adaptivercsailing/adaptivercsailing/Update (As of 03-03-2021).md

**Update** (As of 03-03-2021)

Arduino .ino source code is now available for both **Phase One** and **Phase Two** Projects.
