adaptivercsailing/adaptivercsailing/Phase_1/arduino_src/library_links.md

Links to #included libraries  
&nbsp; &nbsp; Switch DeBouncer https://www.arduinolibraries.info/libraries/bounce2  
&nbsp; &nbsp; X9C Digital Potentiometer https://github.com/ElectricRCAircraftGuy/eRCaGuy_X9C_digital_pot/commit/2f79572f42ab850357adb25ab757ed1f378e10b0
