adaptivercsailing/adaptivercsailing/Phase_2/arduino_src/library_links.md

Links to #included libraries  
&nbsp; &nbsp; Switch DeBouncer https://www.arduinolibraries.info/libraries/bounce2  
&nbsp; &nbsp; Pulse Width Modulation Utility https://github.com/ElectricRCAircraftGuy/eRCaGuy_PPM_Writer
