adaptivercsailing/adaptivercsailing/Phase_1/StripboardLayout.pdf

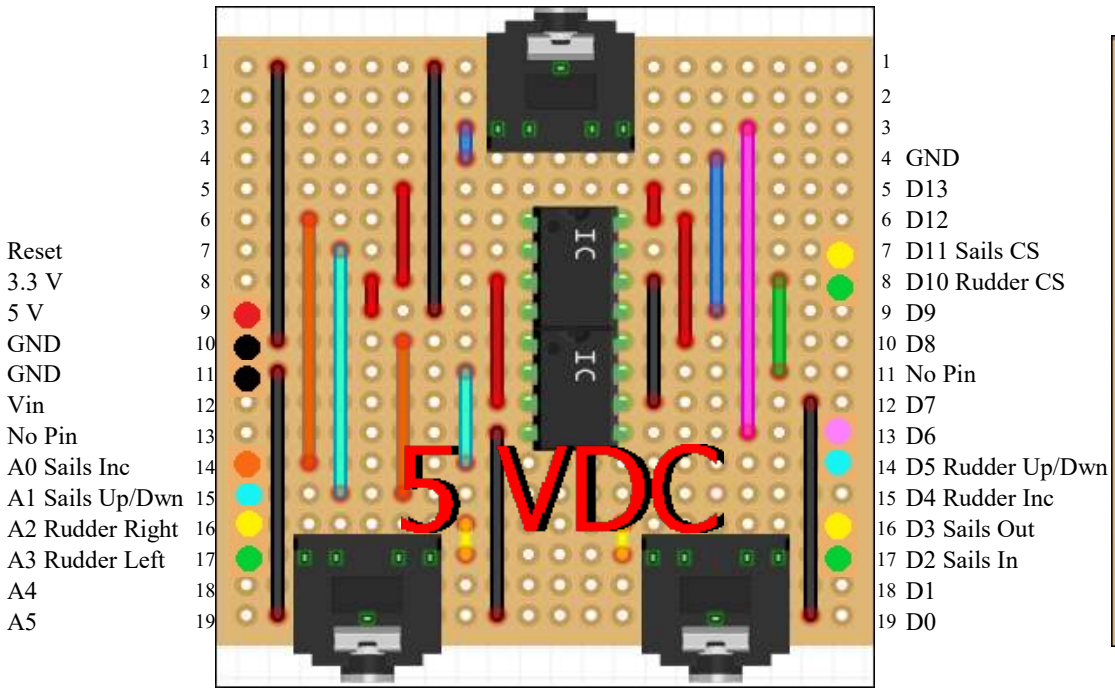
[picture p1: figure]
2 2 3 3 4 4 GND 5 5 D13 6 6 D12; Reset; 7 D11 Sails CS; 8 D10 Rudder CS; GND; 11 No Pin; Vin; No Pin; A0 Sails Inc; 14 D5 Rudder Up/Dwn; A1 Sails Up/Dwn 15; 15 D4 Rudder Inc; A2 Rudder Right 16; 16 D3 Sails Out; A3 Rudder Left 17; 17 D2 Sails In

1 2 3 4 5 6 7 8 9 10 11 12 13 14 15 16 17 18 19 20 | 20 19 18 17 16 15 14 13 12 11 10 9 8 7 6 5 4 3 2 1

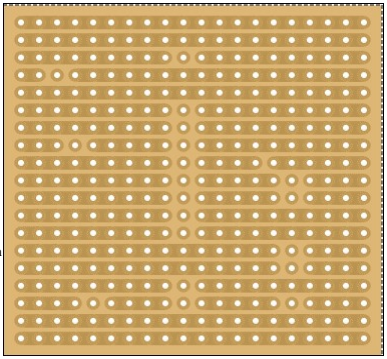
[picture p2: figure]

X9C103 Datasheet available at https://www.renesas.com/cn/en/document/dst/x9c102-x9c103-x9c104-x9c503-datasheet

Arduino Shield (20 columns wide x 19 rows high)

Top View | Copper Strip Side with Trace Breaks Adaptive RC Sailer Interface PCB (5 VDC)

X9C103 Digital Potentiometer Sail & Rudder Pin Assignments
!INC = 1(Inc/Dec) | Vcc = 8 | X9C Digital Potentiometer #A | Arduino | X9C Digital Potentiometer #B | Arduino
U/!D = 2(Up/Dwn) | !CS = 7(Chip Select) | X9C_A_Sails__ChipSelectPin7 | = D11 (11) | X9C_B_Rudder_ChipSelectPin7 = D10 (10)
Vh/Rh = 3 | Vl/Vr = 6 | X9C_A_Sails__UpDownPin2 | = A1 (15) | X9C_B_Rudder_UpDownPin2 | = D5 (5)
GND = 4 | Vw/Rw = 5 | X9C_A_Sails__IncDecPin1 | = A0 (14) | X9C_B_Rudder_IncDecPin1 | = D4 (4)
Note: Must keep !INC LOW while taking !CS HIGH | SailsOutSwitchPin | = D3 (3) Ring RudderLeftSwitchPin | = A3 (17) Ring
U/!D may be changed while !CS is LOW | SailsInSwitchPin | = D2 (2) Tip | RudderRightSwitchPin | = A2 (16) Tip
X9C #A Pin#5 = Sails Servo (Tip) | X9C #B Pin#5=Rudder Servo (Ring)
Arduino Pin Numbers (Not PCB #)
Digital Pins D0 - D13 = Pin # 0 - 13 | Surrogate Adaptive Switch Simulator
Analog Pins A0 - A5 = Pin # 14 - 19 | Sails In (Decrement) = Tip | Sails Out (Increment) = Ring
