adaptivercsailing/adaptivercsailing/Phase_1/Experimental_Phase_1/README.md

Developers - **Please** use this space for all of your contributions and discussion items.

Added Information (03-03-2021)
The following files with explanatory comments were originally uploaded to the Main Branch
by Gabriel Staples ElectricRCAircraftGuy and subsequently moved to the
Phase_1 Experimental Folder (03-03-2021).

&nbsp;  .settings &nbsp;  &nbsp;  Add Eclipse project files &nbsp;Feb 2021

&nbsp;  arduino_src &nbsp;  &nbsp;  Add Test Program  &nbsp;  Feb 2021

&nbsp;  .clang-format &nbsp;  &nbsp;  Fix clang formatter and run it!  &nbsp;  Feb 2021

&nbsp;  .cproject &nbsp;  &nbsp;  Add Eclipse project files  &nbsp;  Feb 2021

&nbsp;  .gitattributes &nbsp;  &nbsp;  Add files via upload  &nbsp;  Dec 2020

&nbsp;  .gitignore &nbsp;  &nbsp;  Add Eclipse project files  &nbsp;  Feb 2021

&nbsp;  .project &nbsp;  &nbsp;  Add Eclipse project files  &nbsp;  Feb 2021

&nbsp;  REN_x9c102-103-104-503_DST_20050310.pdf &nbsp;  Add Renesas datasheet  &nbsp;  Feb 2021

&nbsp;  run_clang-format.sh &nbsp;  &nbsp;  Fix clang formatter and run it!  &nbsp;  Feb 2021
