adaptivercsailing/adaptivercsailing/Phase_2/Experimental_Phase_2/README.md

Developers - **Please** use the space for all of your contributions and discussion items.
