adaptivercsailing/adaptivercsailing/(commit log)

2021-01-30 Run Arduino autoformatter
2021-01-30 Add symlinks so Eclipse can index all Arduino source code and libraries
    Also do some very minor comment changes in Adaptive_RC_Sailer.ino.
    modified: Adaptive_RC_Sailer/Adaptive_RC_Sailer.ino
    new file: arduino_src/README.md
    new file: arduino_src/arduino-1.8.13
    new file: arduino_src/libraries
2021-02-12 Add Test Program
    Changes to be committed:
    new file: Experimental/Test_Save__02-12-2021_/Test_Save__02-12-2021_.ino
    modified: arduino_src/arduino-1.8.13
    modified: arduino_src/libraries
